berlliyanto/Andon-System-Hasura/ESP32/README.md

# Modular Andon System

### Daftar Komponen

#### 1. Master (ESP)
    - ESP 32
    - RFID
    - Ethernet ENC28J60
    - Step Down 5V DC to 3.3 V DC

#### 2. Slave 1 (ESP)
    - ESP 32
    - TFT LCD 3.5 Inch
    - Sensor Proximity Capacitive
    - Step UP 5V DC to 24V DC
    - Relay 24V

#### 3. Slave 2 (ESP)
    - ESP 32
    - Panel DMD RGB (HUB 75)

### Arsitektur Sistem
