berlliyanto/Andon-System-Hasura/ESP32/main/ethernet_config.ino

//INIT ETHERNET
void ethernetBegin(byte mac[]) {

  if (Ethernet.begin(mac)) {
    Serial.println("DHCP OK!");
  } else {
    Serial.println("Failed to configure Ethernet using DHCP");

    if (Ethernet.hardwareStatus() == EthernetNoHardware) {
      Serial.println("Ethernet shield was not found.  Sorry, can't run without hardware. :(");
      while (true) {
        delay(1); 
      }
    }
    if (Ethernet.linkStatus() == LinkOFF) {
      Serial.println("Ethernet cable is not connected.");
    }
  }
  delay(5000);

  Serial.print("Local IP : ");
  Serial.println(Ethernet.localIP());
  Serial.print("Subnet Mask : ");
  Serial.println(Ethernet.subnetMask());
  Serial.print("Gateway IP : ");
  Serial.println(Ethernet.gatewayIP());
  Serial.print("DNS Server : ");
  Serial.println(Ethernet.dnsServerIP());

  Serial.println("Ethernet Successfully Initialized");
}
