berlliyanto/Andon-System-Hasura/Arduino/Slave_2/proximity.ino

void readProximity(){
  int prox = digitalRead(proximityPin);
  if(prox == 0){
    proximityState = 0;
    Serial.println(prox);
  } else {
    proximityState = 1;
    Serial.println(prox);
  }
  delay(1000);
}
