berlliyanto/Andon-System-Hasura/(commit log)

2024-01-11 Change slave from arduino to esp32
2024-02-11 add wiring image
